aa2mz/Tiny-Radio/software/examples/complete radio/readme.md

# Full Radio Build
Such as uBitx or SSB6.1
 
- Hardware: Tiny Radio core plus OLED, rotary encoder and PTT button.
- Features:  Support direct conversion and superheterodyne radios.
Filter selection, IF shift, Keyer, Dual VFOs, Icom 756Pro emulation.

See documenation directory for operating instructions.
