aa2mz/Tiny-Radio/hardware/tiny/Schematic_easyVFO_2020-09-01_15-57-43.png

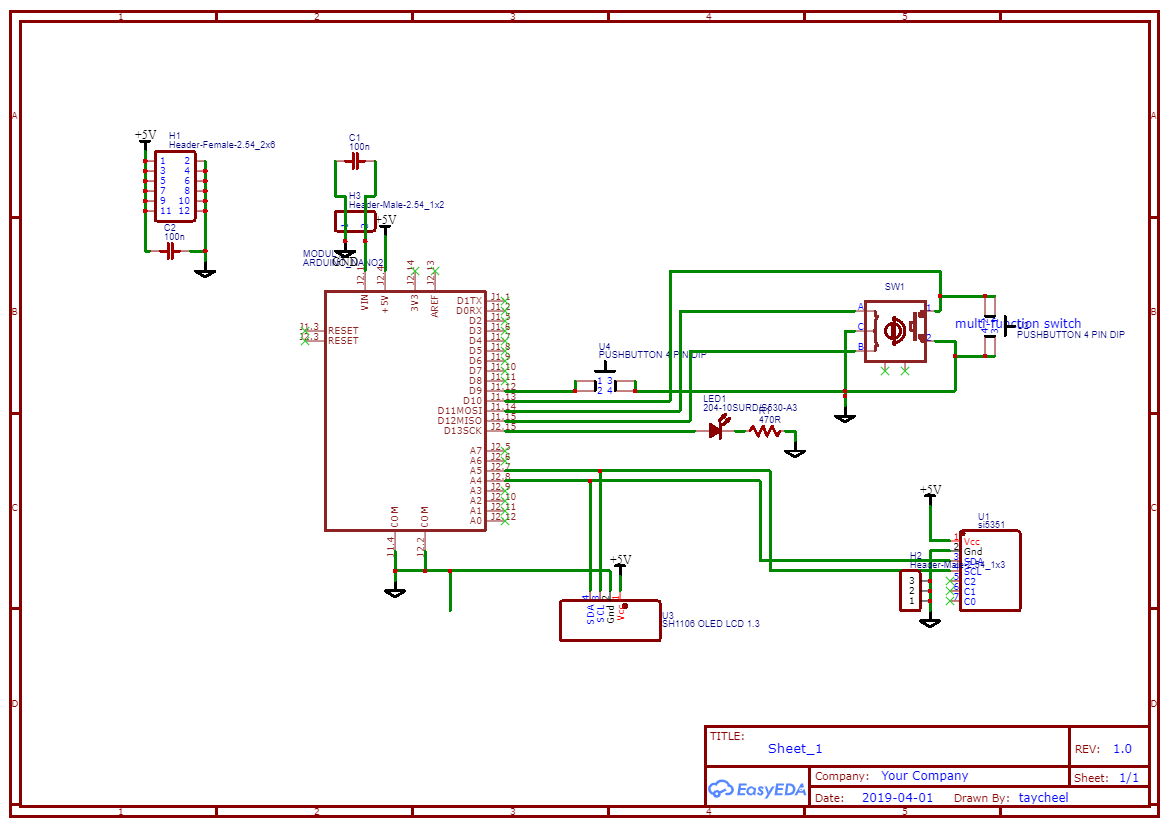
hardware/tiny/Schematic_easyVFO_2020-09-01_15-57-43.png
