aa2mz/Tiny-Radio/hardware/very tiny/0905191019a.jpg

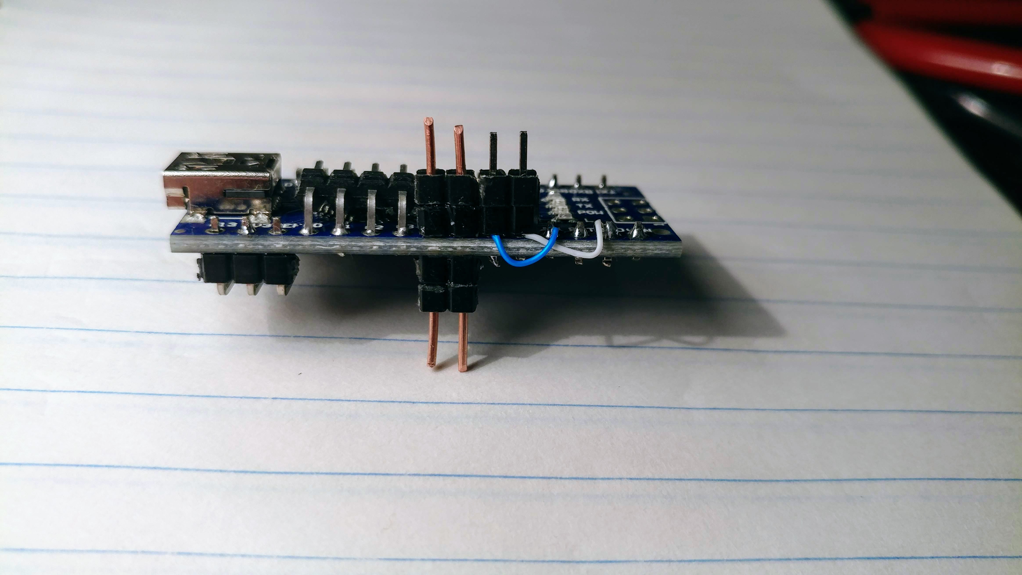
hardware/very tiny/0905191019a.jpg
