aa2mz/Tiny-Radio/hardware/very tiny/0905191316b.jpg

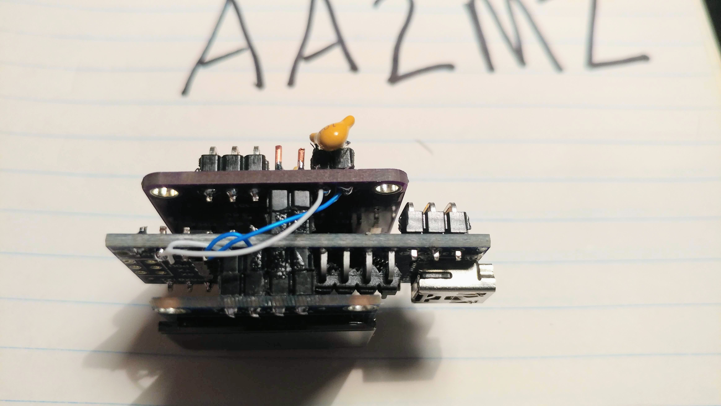
hardware/very tiny/0905191316b.jpg
