aa2mz/Tiny-Radio/hardware/not so tiny/BOM_Tiny Radio Reference Build V2 RC5_2020-08-31_20-35-40.csv

ID | Name | Designator | Footprint | Quantity | Manufacturer Part | Manufacturer | Supplier | Supplier Part | Чип и Дип
1 | si5351 | UCLK | SI5351 | 1 | ?
2 | SN74HC139N | U6 | DIP-16_L19.7-W6.6-P2.54-LS10.9-BL | 1 | SN74HC139N | TI | LCSC | C2906
3 | RK09D1130C2P | IS-POT,A-POT | RK09D1130C2P | 2 | RK09D1130C2P | ALPS Electric | LCSC | C361173
4 | SSB6.1 DDS | H-BSELECT | IDC-TH_16P-P2.54_C3406 | 1 | IDC Box 2.54mm 16P Straight | BOOMELE | LCSC | C3406
5 | ARDUINO_NANO2 | MODUL1 | ARDUINO_NANO2 | 1
6 | Header-Male-2.54_1x3 | H-CLKGND,H-SPK | HDR-TH_3P-P2.54-V | 2 | Header2.54mm 1*3P | BOOMELE | LCSC | C49257
7 | Out-Side | H-K2OUT,H-MXOUT | HDR-TH_3P-P2.54-V | 2 | Header2.54mm 1*3P | BOOMELE | LCSC | C49257
8 | In-Side | H-K2IN,H-MXIN | HDR-TH_3P-P2.54-V | 2 | Header2.54mm 1*3P | BOOMELE | LCSC | C49257
9 | 10n | AC3 | C0805 | 1
10 | 100n | MC1,MC2,SC1,SC2,ISC1 | C0805 | 5
11 | 1u | SC3 | C0805 | 1
12 | 1n5 | BC1,BC4 | C0805 | 2
13 | 560p | BC2,BC3 | C0805 | 2
14 | TX2-5V | K2,KMX | TX2-5V | 2 | TX2-5V | PANASONIC | LCSC | C192257
15 | 100n | C2,C3,SPKC1,VIN-C1 | RAD-0.2 | 4
16 | SH1106 OLED LCD 1.3 | U3 | SH1106_OLED_LCD | 1 | OLED_LCD_SH1106
17 | K3-1235S-L1 | ISELECT | SW-TH_K3-1235S-L1 | 1 | K3-1235S-L1 | Korean Hroparts Elec | LCSC | C223838
18 | 74HC238 | U5 | DIP-16 | 1 | CD74HC238E | Texas Instruments | Чип и Дип | 820490127 | https://www.chipdip.ru/product/74hc238e?from=suggest_product
19 | HR610660 | XFR1 | PWRM-TH_HR610660 | 1 | HR610660 | HANRUN | LCSC | C48357
20 | CW | CWLED | LED-3MM/2.54 | 1 | 204-10SURD/S530-A3 | EVERLIGHT | LCSC | C99772
21 | 2N3904(EBC) | AQ1 | TO-92-3_L5.1-W4.1-P1.27-L | 1 | 2N3904 | SEMTECH | LCSC | C118538
22 | 2N3904 | MQ1,SQ1 | TO-92-3_L5.1-W4.1-P1.27-L | 2 | 2N3904 | SEMTECH | LCSC | C118538
23 | 100uH | SL1 | L_AXIAL-0.5 | 1
24 | 1.5uH | BL1,BL2 | L_AXIAL-0.5 | 2
25 | 1.8uH | BL3 | L_AXIAL-0.5 | 1
26 | PEC11R-4015F-S0024 | ENC-1 | BOURNS_PEC11R-4XXXF-SXXXX | 1 | PEC11R-4015F-S0024 | BOURNS | LCSC | C143789
27 | 470R | CWR1,SPKR2 | AXIAL-0.3 | 2
28 | 1K5 | SPKR1 | AXIAL-0.3 | 1
29 | 4k7 | KEYR3 | AXIAL-0.3 | 1
30 | 2k2 | KEYR2 | AXIAL-0.3 | 1
31 | 10k | KEYR1 | AXIAL-0.3 | 1
32 | HDR-M-2.54_1x2 | AH-VOX,MH-IN,IS-OUT,SH-IN,SH-METER,BH-BCI1,BH-BCI2,AH-KEY | HDR-M-2.54_1X2 | 8 |  |  | LCSC | C124375
33 | CW-Key | H-KEY | HDR-M-2.54_1X3 | 1 |  |  | LCSC | C180248
34 | HDR-IDC-2.54-2X6P | H-2X4SEL | IDC-TH_12P-P2.54_BOOMELE-2X6P-2.54MM | 1 | IDC Box 2X6 2.54MM | BOOMELE | LCSC | C9136
35 | 100 | AR1 | R0805 | 1
36 | 10K | MR1,MR3 | R0805 | 2
37 | 100K | MR2,SR1 | R0805 | 2
38 | 1K | SR2 | R0805 | 1
39 | 1M | SR3 | R0603 | 1
40 | 100K | ISR2,ISR1 | R_AXIAL-0.3 | 2
41 | Power | H-VIN | HDR-2X1/2.54 | 1 | 826629-2 | TE Connectivity | LCSC | C86471
42 | 460n | AC2 | CAP-D5.0×F2.0 | 1
43 | 470n | AC1 | CAP-D5.0×F2.0 | 1
44 | HDR-F-2.54_2x6 | H-ANALOG | HDR-F-2.54_2X6 | 1 |  |  | LCSC | C36191
45 | 1N4148 | KD1,MXD1 | DO-35_BD2.0-L4.0-P8.00-D0.5-FD | 2 | 1N4148 | SEMTECH | LCSC | C14516
46 | PTT-In | PTTIN | PUSH BUTTON 4 PIN DIP | 1 | Pushbutton |  | LAMINGTON
47 | PUSHBUTTON 4 PIN DIP | BUTTON | PUSH BUTTON 4 PIN DIP | 1 | Pushbutton |  | LAMINGTON
48 | 1N5817 | AD1,AD2,AD3,AD4 | DO-41_BD2.4-L4.7-P8.70-D0.9-RD | 4 | 1N5817 | GD | LCSC | C256526
49 | 1n4148 | SD1,SD2 | DO-41_BD2.4-L4.7-P8.70-D0.9-RD | 2 | 1N5817 | GD | LCSC | C256526
