aa2mz/Tiny-Radio/hardware/tiny/PCB_easyVFO_2020-09-01_16-00-13.pdf

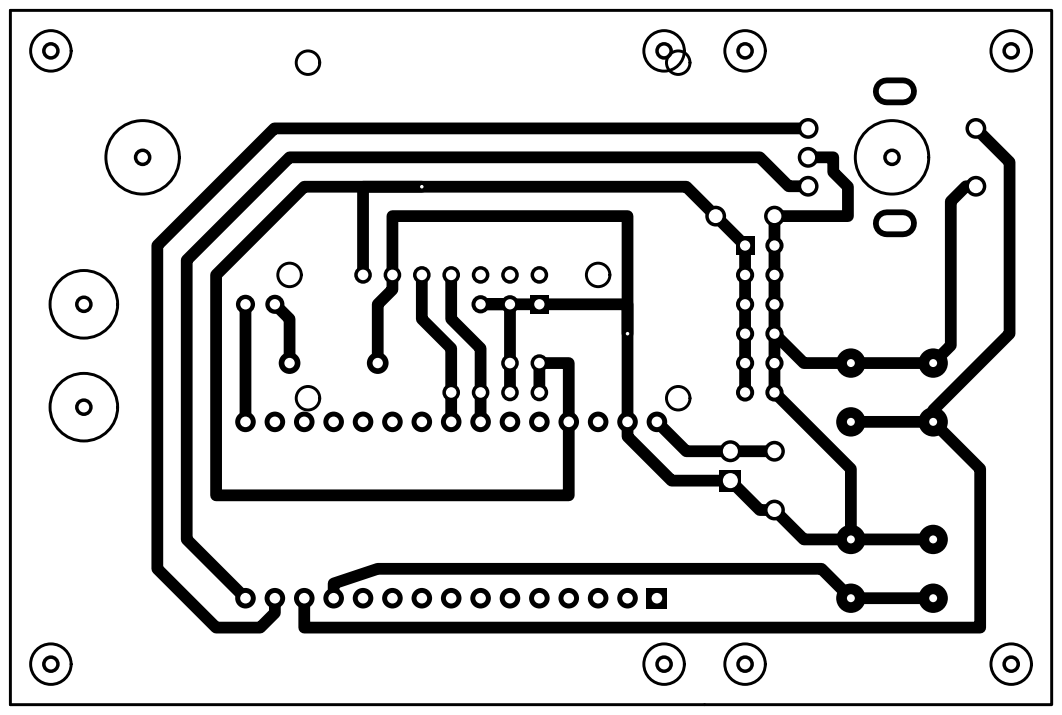
[picture p19: page 1]
