aa2mz/Tiny-Radio/software/ss_oled/ss_oled.cpp

//
/*
 * Copyright 2019,2020, Edward L. Taychert, AA2MZ
 * Modified from Larry's release to prevent unused fonts from being loaded.
    This program is free software: you can redistribute it and/or modify
    it under the terms of the GNU Lesser General Public License as published by
    the Free Software Foundation, either version 3 of the License, or
    (at your option) any later version.
    This program is distributed in the hope that it will be useful,
    but WITHOUT ANY WARRANTY; without even the implied warranty of
    MERCHANTABILITY or FITNESS FOR A PARTICULAR PURPOSE.  See the
    GNU Lesser General Public License for more details.
    You should have received a copy of the GNU Lesser General Public License
    along with this program.  If not, see <https://www.gnu.org/licenses/>.
*/

// ss_oled (Small, Simple OLED library)
// Copyright (c) 2017-2019 BitBank Software, Inc.
// Written by Larry Bank (bitbank@pobox.com)
// Project started 1/15/2017
//
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

#ifdef _LINUX_
#include <stdint.h>
#include <stdlib.h>
#include <unistd.h>
#include <stdio.h>
#include <string.h>
#include <fcntl.h>
#include <sys/ioctl.h>
#include <linux/i2c-dev.h>
#include <math.h>
#define PROGMEM
#define false 0
#define true 1
#define memcpy_P memcpy
static int file_i2c = 0;

#else // Arduino

#include <Arduino.h>
#ifdef __AVR__
#include <avr/pgmspace.h>
#endif
#include <BitBang_I2C.h>
#ifndef __AVR_ATtiny85__
#include <SPI.h>
#endif

#endif // _LINUX_
#include "ss_oled.h"

//
// For non-AVR micros, 1K of RAM isn't fatal
//
#ifndef __AVR__
#define USE_BACKBUFFER
#endif // !__AVR__

// small (8x8) font
const uint8_t ucFont[]PROGMEM = {
0x00,0x00,0x00,0x00,0x00,0x00,0x00,0x00,0x00,0x00,0x06,0x5f,0x5f,0x06,0x00,0x00,
0x00,0x07,0x07,0x00,0x07,0x07,0x00,0x00,0x14,0x7f,0x7f,0x14,0x7f,0x7f,0x14,0x00,
  0x24,0x2e,0x2a,0x6b,0x6b,0x3a,0x12,0x00,0x46,0x66,0x30,0x18,0x0c,0x66,0x62,0x00,
  0x30,0x7a,0x4f,0x5d,0x37,0x7a,0x48,0x00,0x00,0x04,0x07,0x03,0x00,0x00,0x00,0x00,
  0x00,0x1c,0x3e,0x63,0x41,0x00,0x00,0x00,0x00,0x41,0x63,0x3e,0x1c,0x00,0x00,0x00,
  0x08,0x2a,0x3e,0x1c,0x1c,0x3e,0x2a,0x08,0x00,0x08,0x08,0x3e,0x3e,0x08,0x08,0x00,
  0x00,0x00,0x80,0xe0,0x60,0x00,0x00,0x00,0x00,0x08,0x08,0x08,0x08,0x08,0x08,0x00,
  0x00,0x00,0x00,0x60,0x60,0x00,0x00,0x00,0x60,0x30,0x18,0x0c,0x06,0x03,0x01,0x00,
  0x3e,0x7f,0x59,0x4d,0x47,0x7f,0x3e,0x00,0x40,0x42,0x7f,0x7f,0x40,0x40,0x00,0x00,
  0x62,0x73,0x59,0x49,0x6f,0x66,0x00,0x00,0x22,0x63,0x49,0x49,0x7f,0x36,0x00,0x00,
  0x18,0x1c,0x16,0x53,0x7f,0x7f,0x50,0x00,0x27,0x67,0x45,0x45,0x7d,0x39,0x00,0x00,
  0x3c,0x7e,0x4b,0x49,0x79,0x30,0x00,0x00,0x03,0x03,0x71,0x79,0x0f,0x07,0x00,0x00,
  0x36,0x7f,0x49,0x49,0x7f,0x36,0x00,0x00,0x06,0x4f,0x49,0x69,0x3f,0x1e,0x00,0x00,
  0x00,0x00,0x00,0x66,0x66,0x00,0x00,0x00,0x00,0x00,0x80,0xe6,0x66,0x00,0x00,0x00,
  0x08,0x1c,0x36,0x63,0x41,0x00,0x00,0x00,0x00,0x14,0x14,0x14,0x14,0x14,0x14,0x00,
  0x00,0x41,0x63,0x36,0x1c,0x08,0x00,0x00,0x00,0x02,0x03,0x59,0x5d,0x07,0x02,0x00,
  0x3e,0x7f,0x41,0x5d,0x5d,0x5f,0x0e,0x00,0x7c,0x7e,0x13,0x13,0x7e,0x7c,0x00,0x00,
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
{
  return ptr[0] + (ptr[1]<<8);
}
int I2CReadRegister(uint8_t addr, uint8_t reg, uint8_t *pBuf, int iLen)
{
int rc;
  rc = write(file_i2c, &reg, 1);
  rc = read(file_i2c, pBuf, iLen);
  return (rc > 0);
}
int I2CInit(int iSDAPin, int iSCLPin, int32_t iSpeed)
{
char filename[32];

  sprintf(filename, "/dev/i2c-%d", iSDAPin); // I2C bus number passed in SDA pin
  if ((file_i2c = open(filename, O_RDWR)) < 0)
     return 1;
  if (ioctl(file_i2c, I2C_SLAVE, iSCLPin) < 0) // set slave address
  {
     close(file_i2c);
     file_i2c = 0;
     return 1;
  }
  return 0;
}
#endif // _LINUX_

// Wrapper function to write I2C data
#ifdef _LINUX_
static void _I2CWrite(unsigned char *pData, int iLen)
{
  write(file_i2c, pData, iLen);
}
#else // Arduino
static void _I2CWrite(unsigned char *pData, int iLen)
{
#if !defined( __AVR_ATtiny85__ )
  if (iCSPin != -1) // we're writing to SPI, treat it differently
  {
    digitalWrite(iDCPin, (pData[0] == 0) ? LOW : HIGH); // data versus command
    digitalWrite(iCSPin, LOW);
#ifdef HAL_ESP32_HAL_H_ 
   {
   uint8_t ucTemp[1024];
        SPI.transferBytes(&pData[1], ucTemp, iLen-1);
   }
#else
    SPI.transfer(&pData[1], iLen-1);
#endif
    digitalWrite(iCSPin, HIGH);
  }
  else // must be I2C
#endif // !ATtiny85
  {
    I2CWrite(oled_addr, pData, iLen);
  } // I2C
} /* _I2CWrite() */
#endif // _LINUX_

#ifdef FUTURE
static void oledCachedFlush(void)
{
       _I2CWrite(bCache, bEnd); // write the old data
#ifdef USE_BACKBUFFER
       memcpy(&ucScreen[iScreenOffset], &bCache[1], bEnd-1);
       iScreenOffset += (bEnd - 1);
#endif
       bEnd = 1;
} /* oledCachedFlush() */

static void oledCachedWrite(byte *pData, byte bLen)
{

   if (bEnd + bLen > MAX_CACHE) // need to flush it
   {
       oledCachedFlush(); // write the old data
   }
   memcpy(&bCache[bEnd], pData, bLen);
   bEnd += bLen;
  
} /* oledCachedWrite() */
#endif // FUTURE
//
// Turn off the display
//
void oledShutdown(void)
{
uint8_t uc[2];

    uc[0] = 0; // command
    uc[1] = 0xae; // display off
    _I2CWrite(uc, 2);
#ifdef _LINUX_
    close(file_i2c);
    file_i2c = 0;
#endif
} /* oledShutdown() */
#if !defined( __AVR_ATtiny85__ ) && !defined( _LINUX_ )
//
// Initialize the OLED controller for SPI mode
//
void oledSPIInit(int iType, int iDC, int iCS, int iReset, int bFlip, int bInvert, int32_t iSpeed)
{
uint8_t uc[32], *s;
int iLen;

  iDCPin = iDC;
  iCSPin = iCS;
  iResetPin = iReset;
  oled_type = iType;
  oled_flip = bFlip;
  oled_wrap = 0; // default - disable text wrap

  pinMode(iDCPin, OUTPUT);
  pinMode(iCSPin, OUTPUT);
  digitalWrite(iCSPin, HIGH);

  // Reset it
  if (iResetPin != -1)
  {
    pinMode(iResetPin, OUTPUT); 
    digitalWrite(iResetPin, HIGH);
    delay(50);
    digitalWrite(iResetPin, LOW);
    delay(50);
    digitalWrite(iResetPin, HIGH);
    delay(10);
  }
// Initialize SPI
  SPI.begin();
  SPI.beginTransaction(SPISettings(iSpeed, MSBFIRST, SPI_MODE0));
//  SPI.setClockDivider(16);
//  SPI.setBitOrder(MSBFIRST);
//  SPI.setDataMode(SPI_MODE0);

  if (iType == OLED_128x32 || iType == OLED_96x16)
  {
     s = (uint8_t *)oled32_initbuf;
     iLen = sizeof(oled32_initbuf);
  }
  else if (iType == OLED_128x128)
  {
     s = (uint8_t *)oled128_initbuf;
     iLen = sizeof(oled128_initbuf);
  }
  else
  {
     s = (uint8_t *)oled64_initbuf;
     iLen = sizeof(oled64_initbuf);
  }
  memcpy(uc, s, iLen); // do it from RAM
  _I2CWrite(s, iLen);

  if (bInvert)
  {
    uc[0] = 0; // command
    uc[1] = 0xa7; // invert command
    _I2CWrite(uc, 2);
  }
  if (bFlip) // rotate display 180
  {
    uc[0] = 0; // command
    uc[1] = 0xa0;
    _I2CWrite(uc, 2);
    uc[0] = 0;
    uc[1] = 0xc0;
    _I2CWrite(uc, 2);
  }

} /* oledSPIInit() */
#endif
//
// Initializes the OLED controller into "page mode"
//
int oledInit(int iType, int bFlip, int bInvert, int sda, int scl, int32_t iSpeed)
{
unsigned char uc[4];
int rc = OLED_NOT_FOUND;

  oled_type = iType;
  oled_flip = bFlip;
  oled_wrap = 0; // default - disable text wrap
  iSDAPin = sda;
  iSCLPin = scl;
// Disable SPI mode code
  iCSPin = iDCPin = iResetPin = -1;

  I2CInit(sda, scl, iSpeed); // on Linux, SDA = bus number, SCL = device address
#ifdef _LINUX_
  oled_addr = (uint8_t)scl;
#else
  // find the device address
  oled_addr = 0;
  if (I2CTest(0x3c))
     oled_addr = 0x3c;
  else if (I2CTest(0x3d))
     oled_addr = 0x3d;
  else return rc; // no display found!
#endif
  // Detect the display controller (SSD1306, SH1107 or SH1106)
  uint8_t u = 0;
  I2CReadRegister(oled_addr, 0x00, &u, 1); // read the status register
  u &= 0x0f; // mask off power on/off bit
  if (u == 0x7 || u == 0xf) // SH1107
  {
    oled_type = OLED_128x128;
    rc = OLED_SH1107_3C;
    bFlip = !bFlip; // SH1107 seems to have this reversed from the usual direction
  }
  else if (u == 0x8) // SH1106
  {
    rc = OLED_SH1106_3C;
    oled_type = OLED_132x64; // needs to be treated a little differently
  }
  else if (u == 3 || u == 6) // 6=128x64 display, 3=smaller
  {
    rc = OLED_SSD1306_3C;
  }
  if (oled_addr == 0x3d)
     rc++; // return the '3D' version of the type

  if (iType == OLED_128x32 || iType == OLED_96x16)
     _I2CWrite((unsigned char *)oled32_initbuf, sizeof(oled32_initbuf));
  else if (iType == OLED_128x128)
     _I2CWrite((unsigned char *)oled128_initbuf, sizeof(oled128_initbuf));
  else if (iType == OLED_72x40)
     _I2CWrite((unsigned char *)oled72_initbuf, sizeof(oled72_initbuf));
  else // 132x64, 128x64 and 64x32
     _I2CWrite((unsigned char *)oled64_initbuf, sizeof(oled64_initbuf));
  if (bInvert)
  {
    uc[0] = 0; // command
    uc[1] = 0xa7; // invert command
    _I2CWrite(uc, 2);
  }
  if (bFlip) // rotate display 180
  {
    uc[0] = 0; // command
    uc[1] = 0xa0;
    _I2CWrite(uc, 2);
    uc[1] = 0xc0;
    _I2CWrite(uc, 2);
  }
  oled_x = 128; // assume 128x64
  oled_y = 64;
  if (iType == OLED_96x16)
  {
    oled_x = 96;
    oled_y = 16;
  }
  else if (iType == OLED_128x32)
    oled_y = 32;
  else if (iType == OLED_128x128)
    oled_y = 128;
  else if (iType == OLED_64x32)
  {
    oled_x = 64;
    oled_y = 32;
  }
  else if (iType == OLED_72x40)
  {
    oled_x = 72;
    oled_y = 40;
  }
  return rc;
} /* oledInit() */
//
// Sends a command to turn on or off the OLED display
//
void oledPower(uint8_t bOn)
{
    if (bOn)
      oledWriteCommand(0xaf); // turn on OLED
    else
      oledWriteCommand(0xae); // turn off OLED
} /* oledPower() */

// Send a single byte command to the OLED controller
static void oledWriteCommand(unsigned char c)
{
unsigned char buf[2];

  buf[0] = 0x00; // command introducer
  buf[1] = c;
  _I2CWrite(buf, 2);
} /* oledWriteCommand() */

static void oledWriteCommand2(unsigned char c, unsigned char d)
{
unsigned char buf[3];

  buf[0] = 0x00;
  buf[1] = c;
  buf[2] = d;
  _I2CWrite(buf, 3);
} /* oledWriteCommand2() */

//
// Sets the brightness (0=off, 255=brightest)
//
void oledSetContrast(unsigned char ucContrast)
{
  oledWriteCommand2(0x81, ucContrast);
} /* oledSetContrast() */
#ifdef USE_BACKBUFFER
//
// Scroll the internal buffer by 1 scanline (up/down)
// width is in pixels, lines is group of 8 rows
//
int oledScrollBuffer(int iStartCol, int iEndCol, int iStartRow, int iEndRow, int bUp)
{
    uint8_t b, *s;
    int col, row;
    
    if (iStartCol < 0 || iStartCol > 127 || iEndCol < 0 || iEndCol > 127 || iStartCol > iEndCol) // invalid
        return -1;
    if (iStartRow < 0 || iStartRow > 7 || iEndRow < 0 || iEndRow > 7 || iStartRow > iEndRow)
        return -1;
    
    if (bUp)
    {
        for (row=iStartRow; row<=iEndRow; row++)
        {
            s = &ucScreen[(row * 128) + iStartCol];
            for (col=iStartCol; col<=iEndCol; col++)
            {
                b = *s;
                b >>= 1; // scroll pixels 'up'
                if (row < iEndRow)
                    b |= (s[128] << 7); // capture pixel of row below, except for last row
                *s++ = b;
            } // for col
        } // for row
    } // up
    else // down
    {
        for (row=iEndRow; row>=iStartRow; row--)
        {
            s = &ucScreen[(row * 128)+iStartCol];
            for (col=iStartCol; col<=iEndCol; col++)
            {
                b = *s;
                b <<= 1; // scroll down
                if (row > iStartRow)
                    b |= (s[-128] >> 7); // capture pixel of row above
                *s++ = b;
            } // for col
        } // for row
    }
    return 0;
} /* oledScrollBuffer() */
#endif // USE_BACKBUFFER
//
// Send commands to position the "cursor" (aka memory write address)
// to the given row and column
//
static void oledSetPosition(int x, int y, int bRender)
{
unsigned char buf[4];

  iScreenOffset = (y*128)+x;
  if (!bRender)
      return; // don't send the commands to the OLED if we're not rendering the graphics now
  if (oled_type == OLED_64x32) // visible display starts at column 32, row 4
  {
    x += 32; // display is centered in VRAM, so this is always true
    if (oled_flip == 0) // non-flipped display starts from line 4
       y += 4;
  }
  else if (oled_type == OLED_132x64) // SH1106 has 128 pixels centered in 132
  {
    x += 2;
  }
  else if (oled_type == OLED_96x16) // visible display starts at line 2
  { // mapping is a bit strange on the 96x16 OLED
    if (oled_flip)
      x += 32;
    else
      y += 2;
  }
  else if (oled_type == OLED_72x40) // starts at x=28,y=3
  {
    x += 28;
    if (!oled_flip)
    {
      y += 3;
    }
  }
  buf[0] = 0x00; // command introducer
  buf[1] = 0xb0 | y; // set page to Y
  buf[2] = x & 0xf; // lower column address
  buf[3] = 0x10 | (x >> 4); // upper column addr
  _I2CWrite(buf, 4);
} /* oledSetPosition() */

//
// Write a block of pixel data to the OLED
// Length can be anything from 1 to 1024 (whole display)
//
static void oledWriteDataBlock(unsigned char *ucBuf, int iLen, int bRender)
{
unsigned char ucTemp[129];

  ucTemp[0] = 0x40; // data command
// Copying the data has the benefit in SPI mode of not letting
// the original data get overwritten by the SPI.transfer() function
  if (bRender)
  {
      memcpy(&ucTemp[1], ucBuf, iLen);
      _I2CWrite(ucTemp, iLen+1);
  }
  // Keep a copy in local buffer
#ifdef USE_BACKBUFFER
  memcpy(&ucScreen[iScreenOffset], ucBuf, iLen);
  iScreenOffset += iLen;
  iScreenOffset &= ((oled_x * oled_y / 8) - 1);
#endif
}
//
// Byte operands for compressing the data
// The first 2 bits are the type, followed by the counts
#define OP_MASK 0xc0
#define OP_SKIPCOPY 0x00
#define OP_COPYSKIP 0x40
#define OP_REPEATSKIP 0x80
#define OP_REPEAT 0xc0
//
// Write a block of flash memory to the display
//
void oledWriteFlashBlock(byte *s, int iLen)
{
int j;
int iWidthMask = oled_x -1;
int iSizeMask = ((oled_x * oled_y)/8) - 1;
int iWidthShift = (oled_x == 128) ? 7:6; // assume 128 or 64 wide
uint8_t ucTemp[128];

     while (((iScreenOffset & iWidthMask) + iLen) >= oled_x) // if it will hit the page end
     {
        j = oled_x - (iScreenOffset & iWidthMask); // amount we can write in one shot
        memcpy_P(ucTemp, s, j);
        oledWriteDataBlock(ucTemp, j, 1);
        s += j;
        iLen -= j;
        iScreenOffset = (iScreenOffset + j) & iSizeMask;
        oledSetPosition(iScreenOffset & iWidthMask, (iScreenOffset >> iWidthShift), 1);
     } // while it needs some help
  memcpy_P(ucTemp, s, iLen);
  oledWriteDataBlock(ucTemp, iLen, 1);
  iScreenOffset = (iScreenOffset + iLen) & iSizeMask;
} /* oledWriteFlashBlock() */

//
// Write a repeating byte to the display
//
void oledRepeatByte(byte b, int iLen)
{
int j;
int iWidthMask = oled_x -1;
int iWidthShift = (oled_x == 128) ? 7:6; // assume 128 or 64 pixels wide
int iSizeMask = ((oled_x * oled_y)/8) -1;
uint8_t ucTemp[128];

     memset(ucTemp, b, (iLen > 128) ? 128:iLen);
     while (((iScreenOffset & iWidthMask) + iLen) >= oled_x) // if it will hit the page end
     {
        j = oled_x - (iScreenOffset & iWidthMask); // amount we can write in one shot
        oledWriteDataBlock(ucTemp, j, 1);
        iLen -= j;
        iScreenOffset = (iScreenOffset + j) & iSizeMask;
        oledSetPosition(iScreenOffset & iWidthMask, (iScreenOffset >> iWidthShift), 1);
     } // while it needs some help
  oledWriteDataBlock(ucTemp, iLen, 1);
  iScreenOffset += iLen;
} /* oledRepeatByte() */

//
// Play a frame of animation data
// The animation data is assumed to be encoded for a full frame of the display
// Given the pointer to the start of the compressed data,
// it returns the pointer to the start of the next frame
// Frame rate control is up to the calling program to manage
// When it finishes the last frame, it will start again from the beginning
//
uint8_t * oledPlayAnimFrame(uint8_t *pAnimation, uint8_t *pCurrent, int iLen)
{
byte *s;
int i, j;
unsigned char b, bCode;
int iBufferSize = (oled_x * oled_y)/8; // size in bytes of the display devce
int iWidthMask, iWidthShift;

  iWidthMask = oled_x - 1;
  iWidthShift = (oled_x == 128) ? 7:6; // 128 or 64 pixels wide
  if (pCurrent == NULL || pCurrent > pAnimation + iLen)
     return NULL; // invalid starting point

  s = (byte *)pCurrent; // start of animation data
  i = 0;
  oledSetPosition(0,0,1);
  while (i < iBufferSize) // run one frame
  {
    bCode = pgm_read_byte(s++);
    switch (bCode & OP_MASK) // different compression types
    {
      case OP_SKIPCOPY: // skip/copy
        if (bCode == OP_SKIPCOPY) // big skip
        {
           b = pgm_read_byte(s++);
           i += b + 1;
           oledSetPosition(i & iWidthMask, (i >> iWidthShift), 1);
        }
        else // skip/copy
        {
          if (bCode & 0x38)
          {
            i += ((bCode & 0x38) >> 3); // skip amount
            oledSetPosition(i & iWidthMask, (i >> iWidthShift), 1);
          }
          if (bCode & 7)
          {
             oledWriteFlashBlock(s, bCode & 7);
             s += (bCode & 7);
             i += bCode & 7;
          }
       }
       break;
     case OP_COPYSKIP: // copy/skip
       if (bCode == OP_COPYSKIP) // big copy
       {
         b = pgm_read_byte(s++);
         j = b + 1;
         oledWriteFlashBlock(s, j);
         s += j;
         i += j;
       }
       else
       {
         j = ((bCode & 0x38) >> 3);
         if (j)
         {
           oledWriteFlashBlock(s, j);
           s += j;
           i += j;
         }
         if (bCode & 7)
         {
           i += (bCode & 7); // skip
           oledSetPosition(i & iWidthMask, (i >> iWidthShift), 1);
         }
       }
       break;
     case OP_REPEATSKIP: // repeat/skip
       j = (bCode & 0x38) >> 3; // repeat count
       b = pgm_read_byte(s++);
       oledRepeatByte(b, j);
       i += j;
       if (bCode & 7)
       {
         i += (bCode & 7); // skip amount
         oledSetPosition(i & iWidthMask, (i >> iWidthShift), 1);
       }
       break;
                  
     case OP_REPEAT:
       j = (bCode & 0x3f) + 1;
       b = pgm_read_byte(s++);
       oledRepeatByte(b, j);
       i += j;
       break;  
    } // switch on code type
  } // while rendering a frame
  if (s >= pAnimation + iLen) // we've hit the end, restart from the beginning
     s = pAnimation;
  return s; // return pointer to start of next frame
} /* oledPlayAnimFrame() */

//
// Draw a 16x16 tile in any of 4 rotated positions
// Assumes input image is laid out like "normal" graphics with
// the MSB on the left and 2 bytes per line
// On AVR, the source image is assumed to be in FLASH memory
// The function can draw the tile on byte boundaries, so the x value
// can be from 0 to 112 and y can be from 0 to 6
//
void oledDrawTile(const uint8_t *pTile, int x, int y, int iRotation, int bInvert, int bRender)
{
    uint8_t ucTemp[32]; // prepare LCD data here
    uint8_t i, j, k, iOffset, ucMask, uc, ucPixels;
    uint8_t bFlipX=0, bFlipY=0;
    
    if (x < 0 || y < 0 || y > 6 || x > 112)
        return; // out of bounds
    if (pTile == NULL) return; // bad pointer; really? :(
    if (iRotation == ANGLE_180 || iRotation == ANGLE_270 || iRotation == ANGLE_FLIPX)
        bFlipX = 1;
    if (iRotation == ANGLE_180 || iRotation == ANGLE_270 || iRotation == ANGLE_FLIPY)
        bFlipY = 1;
    
    memset(ucTemp, 0, sizeof(ucTemp)); // we only set white pixels, so start from black
    if (iRotation == ANGLE_0 || iRotation == ANGLE_180 || iRotation == ANGLE_FLIPX || iRotation == ANGLE_FLIPY)
    {
        for (j=0; j<16; j++) // y
        {
            for (i=0; i<16; i+=8) // x
            {
                ucPixels = pgm_read_byte(pTile++);
                ucMask = 0x80; // MSB is the first source pixel
                for (k=0; k<8; k++)
                {
                    if (ucPixels & ucMask) // translate the pixel
                    {
                        if (bFlipY)
                            uc = 0x80 >> (j & 7);
                        else
                            uc = 1 << (j & 7);
                        iOffset = i+k;
                        if (bFlipX) iOffset = 15-iOffset;
                        iOffset += (j & 8)<<1; // top/bottom half of output
                        if (bFlipY)
                            iOffset ^= 16;
                        ucTemp[iOffset] |= uc;
                    }
                    ucMask >>= 1;
                } // for k
            } // for i
        } // for j
    }
    else // rotated 90/270
    {
        for (j=0; j<16; j++) // y
        {
            for (i=0; i<16; i+=8) // x
            {
                ucPixels = pgm_read_byte(pTile++);
                ucMask = 0x80; // MSB is the first source pixel
                for (k=0; k<8; k++)
                {
                    if (ucPixels & ucMask) // translate the pixel
                    {
                        if (bFlipY)
                            uc = 0x80 >> k;
                        else
                            uc = 1 << k;
                        iOffset = 15-j;
                        if (bFlipX) iOffset = 15-iOffset;
                        iOffset += i<<1; // top/bottom half of output
                        if (bFlipY)
                            iOffset ^= 16;
                        ucTemp[iOffset] |= uc;
                    }
                    ucMask >>= 1;
                } // for k
            } // for i
        } // for j
    }
    if (bInvert) InvertBytes(ucTemp, 32);
    // Send the data to the display
    oledSetPosition(x, y, bRender);
    oledWriteDataBlock(ucTemp, 16, bRender); // top half
    oledSetPosition(x,y+1, bRender);
    oledWriteDataBlock(&ucTemp[16], 16, bRender); // bottom half
} /* oledDrawTile() */

// Set (or clear) an individual pixel
// The local copy of the frame buffer is used to avoid
// reading data from the display controller
int oledSetPixel(int x, int y, unsigned char ucColor, int bRender)
{
int i;
unsigned char uc, ucOld;

  i = ((y >> 3) * 128) + x;
  if (i < 0 || i > 1023) // off the screen
    return -1;
  oledSetPosition(x, y>>3, bRender);

#ifdef USE_BACKBUFFER
  uc = ucOld = ucScreen[i];
#else
  if (oled_type == OLED_132x64 || oled_type == OLED_128x128) // SH1106/SH1107 can read data
  {
  uint8_t ucTemp[3];
     ucTemp[0] = 0x80; // one command
     ucTemp[1] = 0xE0; // read_modify_write
     ucTemp[2] = 0xC0; // one data
     _I2CWrite(ucTemp, 3);

     // read a dummy byte followed by the data byte we want
     I2CRead(oled_addr, ucTemp, 2);
     uc = ucOld = ucTemp[1]; // first byte is garbage 
  }
  else
     uc = ucOld = 0;
#endif

  uc &= ~(0x1 << (y & 7));
  if (ucColor)
  {
    uc |= (0x1 << (y & 7));
  }
  if (uc != ucOld) // pixel changed
  {
//    oledSetPosition(x, y>>3);
#ifdef USE_BACKBUFFER
    oledWriteDataBlock(&uc, 1, bRender);
    ucScreen[i] = uc;
#else
    if (oled_type == OLED_132x64 || oled_type == OLED_128x128) // end the read_modify_write operation
    {
    uint8_t ucTemp[4];
      ucTemp[0] = 0xc0; // one data
      ucTemp[1] = uc;   // actual data
      ucTemp[2] = 0x80; // one command
      ucTemp[3] = 0xEE; // end read_modify_write operation
      _I2CWrite(ucTemp, 4);
    }
#endif
  }
  return 0;
} /* oledSetPixel() */

//
// Invert font data
//
void InvertBytes(uint8_t *pData, uint8_t bLen)
{
uint8_t i;
   for (i=0; i<bLen; i++)
   {
      *pData = ~(*pData);
      pData++;
   }
} /* InvertBytes() */

//
// Load a 128x64 1-bpp Windows bitmap
// Pass the pointer to the beginning of the BMP file
// First pass version assumes a full screen bitmap
//
int oledLoadBMP(uint8_t *pBMP, int bInvert, int bRender)
{
int16_t i16;
int iOffBits, q, y, j; // offset to bitmap data
int iPitch;
uint8_t x, z, b, *s;
uint8_t dst_mask;
uint8_t ucTemp[16]; // process 16 bytes at a time
uint8_t bFlipped = false;

  i16 = pgm_read_word(pBMP);
  if (i16 != 0x4d42) // must start with 'BM'
     return -1; // not a BMP file
  i16 = pgm_read_word(pBMP + 18);
  if (i16 != 128) // must be 128 pixels wide
     return -1;
  i16 = pgm_read_word(pBMP + 22);
  if (i16 != 64 && i16 != -64) // must be 64 pixels tall
     return -1;
  if (i16 == 64) // BMP is flipped vertically (typical)
     bFlipped = true;
  i16 = pgm_read_word(pBMP + 28);
  if (i16 != 1) // must be 1 bit per pixel
     return -1;
  iOffBits = pgm_read_word(pBMP + 10);
  iPitch = 16;
  if (bFlipped)
  { 
    iPitch = -16;
    iOffBits += (63 * 16); // start from bottom
  }

// rotate the data and send it to the display
  for (y=0; y<8; y++) // 8 lines of 8 pixels
  {
     oledSetPosition(0, y, bRender);
     for (j=0; j<8; j++) // do 8 sections of 16 columns
     {
         s = &pBMP[iOffBits + (j*2) + (y * iPitch*8)]; // source line
         memset(ucTemp, 0, 16); // start with all black
         for (x=0; x<16; x+=8) // do each block of 16x8 pixels
         {
            dst_mask = 1;
            for (q=0; q<8; q++) // gather 8 rows
            {
               b = pgm_read_byte(s + (q * iPitch));
               for (z=0; z<8; z++) // gather up the 8 bits of this column
               {
                  if (b & 0x80)
                      ucTemp[x+z] |= dst_mask;
                  b <<= 1;
               } // for z
               dst_mask <<= 1;
            } // for q
            s++; // next source byte
         } // for x
         if (bInvert) InvertBytes(ucTemp, 16);
         oledWriteDataBlock(ucTemp, 16, bRender);
     } // for j
  } // for y
  return 0;
} /* oledLoadBMP() */
//
// Set the current cursor position
// The column represents the pixel column (0-127)
// The row represents the text row (0-7)
//
void oledSetCursor(int x, int y)
{
  iCursorX = x; iCursorY = y;
} /* oledSetCursor() */
//
// Turn text wrap on or off for the oldWriteString() function
//
void oledSetTextWrap(int bWrap)
{
  oled_wrap = bWrap;
} /* oledSetTextWrap() */
//
// Draw a string of normal (8x8), small (6x8) or large (16x32) characters
// At the given col+row
//
/* 
 *  Modified for Tiny Radio by ELT 
 *  Individual routines were created to write different string sizes to 
 *  avoid using this routine which fill force all fonts to be loaded
 *  whether they are used or not. 
 */

int oledWriteString(int iScroll, int x, int y, char *szMsg, int iSize, int bInvert, int bRender)
{

    if (iSize == FONT_NORMAL) // 8x8 font
    {
       oledWriteStringNormal(iScroll, x, y, szMsg, bInvert, bRender);
       return 0;
    } // 8x8
#ifndef __AVR__
    else if (iSize == FONT_LARGE) // 16x32 font
    {
      oledWriteStringLarge(iScroll, x, y, szMsg, bInvert, bRender);
      return 0;
    } // 16x32
#endif // !__AVR__
    else if (iSize == FONT_STRETCHED) // 8x8 stretched to 16x16
    {
      oledWriteStringStretched(iScroll, x, y, szMsg, bInvert, bRender);
      return 0;
    } // 16x16
    else if (iSize == FONT_SMALL) // 6x8 font
    {
      oledWriteStringSmall(iScroll, x, y, szMsg, bInvert, bRender);
      return 0;
    } // 6x8
  return -1; // invalid size
} /* oledWriteString() */

int oledWriteStringNormal(int iScroll, int x, int y, char *szMsg, int bInvert, int bRender)
{
int i, iFontOff, iLen, iFontSkip;
unsigned char c, *s, ucTemp[40];

    if (x == -1 || y == -1) // use the cursor position
    {
      x = iCursorX; y = iCursorY;
    }
    else
    {
      iCursorX = x; iCursorY = y; // set the new cursor position
    }
    if (iCursorX >= oled_x || iCursorY >= oled_y / 8)
       return -1; // can't draw off the display

    oledSetPosition(iCursorX, iCursorY, bRender);
//    if (iSize == FONT_NORMAL) // 8x8 font
//    {
       i = 0;
       iFontSkip = iScroll & 7; // number of columns to initially skip
       while (iCursorX < oled_x && szMsg[i] != 0 && iCursorY < oled_y / 8)
       {
         if (iScroll < 8) // only display visible characters
         {
             c = (unsigned char)szMsg[i];
             iFontOff = (int)(c-32) * 8;
             // we can't directly use the pointer to FLASH memory, so copy to a local buffer
             memcpy_P(ucTemp, &ucFont[iFontOff], 8);
             if (bInvert) InvertBytes(ucTemp, 8);
    //         oledCachedWrite(ucTemp, 8);
             iLen = 8 - iFontSkip;
             if (iCursorX + iLen > oled_x) // clip right edge
                 iLen = oled_x - iCursorX;
             oledWriteDataBlock(&ucTemp[iFontSkip], iLen, bRender); // write character pattern
             iCursorX += iLen;
             if (iCursorX >= oled_x && oled_wrap) // word wrap enabled?
             {
               iCursorX = 0; // start at the beginning of the next line
               iCursorY++;
               oledSetPosition(iCursorX, iCursorY, bRender);
             }
             iFontSkip = 0;
         }
         iScroll -= 8;
         i++;
       } // while
//     oledCachedFlush(); // write any remaining data
       return 0;
//    } // 8x8
} // oledWriteScringNormal

int oledWriteStringLarge(int iScroll, int x, int y, char *szMsg, int bInvert, int bRender)
{
int i, iFontOff, iLen, iFontSkip;
unsigned char c, *s, ucTemp[40];

    if (x == -1 || y == -1) // use the cursor position
    {
      x = iCursorX; y = iCursorY;
    }
    else
    {
      iCursorX = x; iCursorY = y; // set the new cursor position
    }
    if (iCursorX >= oled_x || iCursorY >= oled_y / 8)
       return -1; // can't draw off the display

    oledSetPosition(iCursorX, iCursorY, bRender);
//    else if (iSize == FONT_LARGE) // 16x32 font
//    {
      i = 0;
      iFontSkip = iScroll & 15; // number of columns to initially skip
      while (iCursorX < oled_x && iCursorY < (oled_y / 8)-3 && szMsg[i] != 0)
      {
          if (iScroll < 16) // if characters are visible
          {
              s = (unsigned char *)&ucBigFont[(unsigned char)(szMsg[i]-32)*64];
              iLen = 16 - iFontSkip;
              if (iCursorX + iLen > oled_x) // clip right edge
                  iLen = oled_x - iCursorX;
              // we can't directly use the pointer to FLASH memory, so copy to a local buffer
              oledSetPosition(iCursorX, iCursorY, bRender);
              memcpy_P(ucTemp, s, 16);
              if (bInvert) InvertBytes(ucTemp, 16);
              oledWriteDataBlock(&ucTemp[iFontSkip], iLen, bRender); // write character pattern
              oledSetPosition(iCursorX, iCursorY+1, bRender);
              memcpy_P(ucTemp, s+16, 16);
              if (bInvert) InvertBytes(ucTemp, 16);
              oledWriteDataBlock(&ucTemp[iFontSkip], iLen, bRender); // write character pattern
              if (iCursorY <= 5)
              {
                 oledSetPosition(iCursorX, iCursorY+2, bRender);
                 memcpy_P(ucTemp, s+32, 16);
                 if (bInvert) InvertBytes(ucTemp, 16);
                 oledWriteDataBlock(&ucTemp[iFontSkip], iLen, bRender); // write character pattern
              }
              if (iCursorY <= 4)
              {
                 oledSetPosition(iCursorX, iCursorY+3, bRender);
                 memcpy_P(ucTemp, s+48, 16);
                 if (bInvert) InvertBytes(ucTemp, 16);
                 oledWriteDataBlock(&ucTemp[iFontSkip], iLen, bRender); // write character pattern
              }
              iCursorX += iLen;
              if (iCursorX >= oled_x && oled_wrap) // word wrap enabled?
              {
                iCursorX = 0; // start at the beginning of the next line
                iCursorY+=4;
              }
              iFontSkip = 0;
          } // if character visible from scrolling
          iScroll -= 16;
          i++;
       } // while
       return 0;
//    } // 16x32
} // oledWriteStringLarge

int oledWriteStringStretched(int iScroll, int x, int y, char *szMsg, int bInvert, int bRender)
{
int i, iFontOff, iLen, iFontSkip;
unsigned char c, *s, ucTemp[40];

    if (x == -1 || y == -1) // use the cursor position
    {
      x = iCursorX; y = iCursorY;
    }
    else
    {
      iCursorX = x; iCursorY = y; // set the new cursor position
    }
    if (iCursorX >= oled_x || iCursorY >= oled_y / 8)
       return -1; // can't draw off the display

    oledSetPosition(iCursorX, iCursorY, bRender);
//    else if (iSize == FONT_STRETCHED) // 8x8 stretched to 16x16
//    {
      i = 0;
      iFontSkip = iScroll & 15; // number of columns to initially skip
      while (iCursorX < oled_x && iCursorY < (oled_y/8)-1 && szMsg[i] != 0)
      {   
// stretch the 'normal' font instead of using the big font
          if (iScroll < 16) // if characters are visible
          {
              int tx, ty;
              c = szMsg[i] - 32;
              unsigned char uc1, uc2, ucMask, *pDest;
              s = (unsigned char *)&ucFont[(int)c*8];
              memcpy_P(ucTemp, s, 8);
              if (bInvert)
                  InvertBytes(ucTemp, 8);
              // Stretch the font to double width + double height
              memset(&ucTemp[8], 0, 32); // write 32 new bytes
              for (tx=0; tx<8; tx++)
              {
                  ucMask = 3;
                  pDest = &ucTemp[8+tx*2];
                  uc1 = uc2 = 0;
                  c = ucTemp[tx];
                  for (ty=0; ty<4; ty++)
                  {
                      if (c & (1 << ty)) // a bit is set
                          uc1 |= ucMask;
                      if (c & (1 << (ty + 4)))
                          uc2 |= ucMask;
                      ucMask <<= 2;
                  }
                  pDest[0] = uc1;
                  pDest[1] = uc1; // double width
                  pDest[16] = uc2;
                  pDest[17] = uc2;
              }
              iLen = 16 - iFontSkip;
              if (iCursorX + iLen > oled_x) // clip right edge
                  iLen = oled_x - iCursorX;
              oledSetPosition(iCursorX, iCursorY, bRender);
              oledWriteDataBlock(&ucTemp[8+iFontSkip], iLen, bRender);
              oledSetPosition(iCursorX, iCursorY+1, bRender);
              oledWriteDataBlock(&ucTemp[24+iFontSkip], iLen, bRender);
              iCursorX += iLen;
              if (iCursorX >= oled_x && oled_wrap) // word wrap enabled?
              {
                iCursorX = 0; // start at the beginning of the next line
                iCursorY += 2;
                oledSetPosition(iCursorX, iCursorY, bRender);
              }
              iFontSkip = 0;
          } // if characters are visible
          iScroll -= 16;
          i++;
      } // while
      return 0;
//    } // 16x16
} // oldWriteStringStretched

int oledWriteStringSmall(int iScroll, int x, int y, char *szMsg, int bInvert, int bRender)
{
int i, iFontOff, iLen, iFontSkip;
unsigned char c, *s, ucTemp[40];

    if (x == -1 || y == -1) // use the cursor position
    {
      x = iCursorX; y = iCursorY;
    }
    else
    {
      iCursorX = x; iCursorY = y; // set the new cursor position
    }
    if (iCursorX >= oled_x || iCursorY >= oled_y / 8)
       return -1; // can't draw off the display

    oledSetPosition(iCursorX, iCursorY, bRender);
//    else if (iSize == FONT_SMALL) // 6x8 font
//    {
       i = 0;
       iFontSkip = iScroll % 6;
       while (iCursorX < oled_x && iCursorY < (oled_y/8) && szMsg[i] != 0)
       {
           if (iScroll < 6) // if characters are visible
           {
               c = szMsg[i] - 32;
               // we can't directly use the pointer to FLASH memory, so copy to a local buffer
               memcpy_P(ucTemp, &ucSmallFont[(int)c*6], 6);
               if (bInvert) InvertBytes(ucTemp, 6);
               iLen = 6 - iFontSkip;
               if (iCursorX + iLen > oled_x) // clip right edge
                   iLen = oled_x - iCursorX;
               oledWriteDataBlock(&ucTemp[iFontSkip], iLen, bRender); // write character pattern
    //         oledCachedWrite(ucTemp, 6);
               iCursorX += iLen;
               iFontSkip = 0;
               if (iCursorX >= oled_x && oled_wrap) // word wrap enabled?
               {
                 iCursorX = 0; // start at the beginning of the next line
                 iCursorY++;
                 oledSetPosition(iCursorX, iCursorY, bRender);
               }
           } // if characters are visible
         iScroll -= 6;
         i++;
       }
//    oledCachedFlush(); // write any remaining data      
      return 0;
//    } // 6x8
} // oledWriteStringSmall
//
// Render a sprite/rectangle of pixels from a provided buffer to the display.
// The row values refer to byte rows, not pixel rows due to the memory
// layout of OLEDs.
// returns 0 for success, -1 for invalid parameter
//
int oledDrawGFX(uint8_t *pBuffer, int iSrcCol, int iSrcRow, int iDestCol, int iDestRow, int iWidth, int iHeight, int iSrcPitch)
{
    int y;
    
    if (iSrcCol < 0 || iSrcCol > 127 || iSrcRow < 0 || iSrcRow > 7 || iDestCol < 0 || iDestCol >= oled_x || iDestRow < 0 || iDestRow >= (oled_y >> 3) || iSrcPitch <= 0)
        return -1; // invalid
    
    for (y=iSrcRow; y<iSrcRow+iHeight; y++)
    {
        uint8_t *s = &pBuffer[(y * iSrcPitch)+iSrcCol];
        oledSetPosition(iDestCol, iDestRow, 1);
        oledWriteDataBlock(s, iWidth, 1);
        pBuffer += iSrcPitch;
        iDestRow++;
    } // for y
    return 0;
} /* oledDrawGFX() */
//
// Dump a screen's worth of data directly to the display
// Try to speed it up by comparing the new bytes with the existing buffer
//
void oledDumpBuffer(uint8_t *pBuffer)
{
int x, y;
int iLines, iCols;
uint8_t bNeedPos;
#ifdef USE_BACKBUFFER
uint8_t *pSrc = ucScreen;
    
    if (pBuffer == NULL) // dump the internal buffer if none is given
        pBuffer = ucScreen;
#endif
    
  iLines = oled_y >> 3;
  iCols = oled_x >> 4;
  for (y=0; y<iLines; y++)
  {
    bNeedPos = 1; // start of a new line means we need to set the position too
    for (x=0; x<iCols; x++) // wiring library has a 32-byte buffer, so send 16 bytes so that the data prefix (0x40) can fit
    {
#ifdef USE_BACKBUFFER
      if (pSrc == pBuffer || memcmp(pSrc, pBuffer, 16) != 0) // doesn't match, need to send it
#else
      if (1)
#endif
      {
        if (bNeedPos) // need to reposition output cursor?
        {
           bNeedPos = 0;
           oledSetPosition(x*16, y, 1);
        }
        oledWriteDataBlock(pBuffer, 16, 1);
      }
      else
      {
         bNeedPos = 1; // we're skipping a block, so next time will need to set the new position
      }
#ifdef USE_BACKBUFFER
      pSrc += 16;
#endif
      pBuffer += 16;
    } // for x
#ifdef USE_BACKBUFFER
    pSrc += (128 - oled_x); // for narrow displays, skip to the next line
#endif
    pBuffer += (128 - oled_x);
  } // for y

} /* oledDumpBuffer() */
//
// Fill the frame buffer with a byte pattern
// e.g. all off (0x00) or all on (0xff)
//
void oledFill(unsigned char ucData, int bRender)
{
uint8_t x, y;
uint8_t iLines, iCols;
unsigned char temp[16];

  iLines = oled_y >> 3;
  iCols = oled_x >> 4;
  memset(temp, ucData, 16);
  iCursorX = iCursorY = 0;
 
  for (y=0; y<iLines; y++)
  {
    oledSetPosition(0,y, bRender); // set to (0,Y)
    for (x=0; x<iCols; x++) // wiring library has a 32-byte buffer, so send 16 bytes so that the data prefix (0x40) can fit
    {
      oledWriteDataBlock(temp, 16, bRender);
    } // for x
    // 72 isn't evenly divisible by 16, so fix it
    if (oled_type == OLED_72x40)
       oledWriteDataBlock(temp, 8, bRender);
  } // for y
#ifdef USE_BACKBUFFER
   memset(ucScreen, ucData, 1024);
#endif
} /* oledFill() */

#ifdef USE_BACKBUFFER
//
// Return the pointer to the internal back buffer
// this allows a sketch to do direct manipulation of the pixels
// and later use oledDumpBuffer() to draw the updated display
//
uint8_t * oledGetBuffer(void)
{
  return (uint8_t *)&ucScreen[0];
} /* oledGetBuffer() */

void oledDrawLine(int x1, int y1, int x2, int y2, int bRender)
{
  int temp;
  int dx = x2 - x1;
  int dy = y2 - y1;
  int error;
  uint8_t *p, *pStart, mask, bOld, bNew;
  int xinc, yinc;
  int y, x;
  
  if (x1 < 0 || x2 < 0 || y1 < 0 || y2 < 0 || x1 > 127 || x2 > 127 || y1 > 63 || y2 > 63)
     return;

  if(abs(dx) > abs(dy)) {
    // X major case
    if(x2 < x1) {
      dx = -dx;
      temp = x1;
      x1 = x2;
      x2 = temp;
      temp = y1;
      y1 = y2;
      y2 = temp;
    }

    y = y1;
    dy = (y2 - y1);
    error = dx >> 1;
    yinc = 1;
    if (dy < 0)
    {
      dy = -dy;
      yinc = -1;
    }
    p = pStart = &ucScreen[x1 + ((y >> 3) << 7)]; // point to current spot in back buffer
    mask = 1 << (y & 7); // current bit offset
    for(x=x1; x1 <= x2; x1++) {
      *p++ |= mask; // set pixel and increment x pointer
      error -= dy;
      if (error < 0)
      {
        error += dx;
        if (yinc > 0)
           mask <<= 1;
        else
           mask >>= 1;
        if (mask == 0) // we've moved outside the current row, write the data we changed
        {
           oledSetPosition(x, y>>3, bRender);
           oledWriteDataBlock(pStart,  (int)(p-pStart), bRender); // write the row we changed
           x = x1+1; // we've already written the byte at x1
           y1 = y+yinc;
           p += (yinc > 0) ? 128 : -128;
           pStart = p;
           mask = 1 << (y1 & 7);
        }
        y += yinc;
      }
    } // for x1    
   if (p != pStart) // some data needs to be written
   {
     oledSetPosition(x, y>>3, bRender);
     oledWriteDataBlock(pStart, (int)(p-pStart), bRender);
   }
  }
  else {
    // Y major case
    if(y1 > y2) {
      dy = -dy;
      temp = x1;
      x1 = x2;
      x2 = temp;
      temp = y1;
      y1 = y2;
      y2 = temp;
    } 

    p = &ucScreen[x1 + ((y1 >> 3) * 128)]; // point to current spot in back buffer
    bOld = bNew = p[0]; // current data at that address
    mask = 1 << (y1 & 7); // current bit offset
    dx = (x2 - x1);
    error = dy >> 1;
    xinc = 1;
    if (dx < 0)
    {
      dx = -dx;
      xinc = -1;
    }
    for(x = x1; y1 <= y2; y1++) {
      bNew |= mask; // set the pixel
      error -= dx;
      mask <<= 1; // y1++
      if (mask == 0) // we're done with this byte, write it if necessary
      {
        if (bOld != bNew)
        {
          p[0] = bNew; // save to RAM
          oledSetPosition(x, y1>>3, bRender);
          oledWriteDataBlock(&bNew, 1, bRender);
        }
        p += 128; // next line
        bOld = bNew = p[0];
        mask = 1; // start at LSB again
      }
      if (error < 0)
      {
        error += dy;
        if (bOld != bNew) // write the last byte we modified if it changed
        {
          p[0] = bNew; // save to RAM
          oledSetPosition(x, y1>>3, bRender);
          oledWriteDataBlock(&bNew, 1, bRender);
        }
        p += xinc;
        x += xinc;
        bOld = bNew = p[0];
      }
    } // for y
    if (bOld != bNew) // write the last byte we modified if it changed
    {
      p[0] = bNew; // save to RAM
      oledSetPosition(x, y2>>3, bRender);
      oledWriteDataBlock(&bNew, 1, bRender);
    }
  } // y major case
} /* oledDrawLine() */
#endif // USE_BACKBUFFER
