aa2mz/Tiny-Radio/(commit log)

2020-09-01 Add files via upload
    Gerber files and EasyEDA schematic and board
    [BOM_Tiny Radio Reference Build V2 RC5_2020-08-31_20-35-40.csv]
2020-09-01 Update readme.md
    Added pictures and assembly information.
2020-09-01 Add files via upload
    added designed-for enclosure
2020-09-01 Add files via upload
    add schematic and PDF
2020-09-02 Update readme.md
    added notes to the schematics
2020-09-15 Update readme.md
    Testing PCB to date
2020-09-18 update example to current core
2020-09-18 update core to current examples
